kiranasokan2002/riscv32-verilog-fpga/alu.v

module alu (
    input  [31:0] A, B,
    input  [ 3:0] ALUCtrl,
    output reg [31:0] Result,
    output        Zero
);
    assign Zero = (Result == 32'b0);
    always @(*) begin
        case (ALUCtrl)
            4'b0000: Result = A + B;
            4'b0001: Result = A - B;
            4'b0010: Result = A & B;
            4'b0011: Result = A | B;
            4'b0100: Result = A ^ B;
            4'b0101: Result = A << B[4:0];
            4'b0110: Result = A >> B[4:0];
            4'b0111: Result = $signed(A) >>> B[4:0];
            4'b1000: Result = ($signed(A) < $signed(B)) ? 32'd1 : 32'd0;
            4'b1001: Result = (A < B) ? 32'd1 : 32'd0;
            default: Result = 32'b0;
        endcase
    end
endmodule
