kiranasokan2002/riscv32-verilog-fpga/program_counter.v

module program_counter (
    input         clk,
    input         rst,
    input  [31:0] pc_next,
    output reg [31:0] pc
);
    always @(posedge clk) begin
        if (rst) pc <= 32'h00000000;
        else     pc <= pc_next;
    end
endmodule
